jaxonFowler/Clay-Counter/hardware/Clay Counter BOM - Rev4.0.xlsx

Carted? | RefDes | Item | Tolerance | Qty | Purchase Location
TRUE | U1 | ESP32-C3-MINI-1 |  | 1 | Digikey
TRUE | U2 | OLED |  | 1 | Universal Solder
TRUE | U3 | MCP1700T-3302E/TT |  | 1 | Digikey
TRUE | J1 | TP4056 |  | 1 | Amazon
TRUE | J2 | USBC Jack |  | 1 | Unikeyic
TRUE | BT1 | 18650 Battery |  | 1 | Digikey
TRUE | SW1 | Slide Switch |  | 1 | Digikey
TRUE | SW2 & NAV | Button Switch |  | 6 | Digikey
TRUE | R1-R2 | 4.7K Resistor | 5% | 2 | Digikey
TRUE | R3-R7 | 10K Resistor | 5% | 5 | Digikey
TRUE | R8-R9 | 100K Resistor | 1% | 2 | Digikey
TRUE | R10-R11 | 5.1K Resistor | 5% | 2 | Digikey
TRUE | C1 | 10uF Capacitor | 10% | 1 | Unikeyic
TRUE | C2-C3 | 100nF Capacitor | 5% | 2 | Unikeyic
TRUE | C4 | 4.7uF Capacitor | 10% | 1 | Unikeyic
