jaxonFowler/Clay-Counter/hardware/ClayCounterCircuit-V2.0.pdf

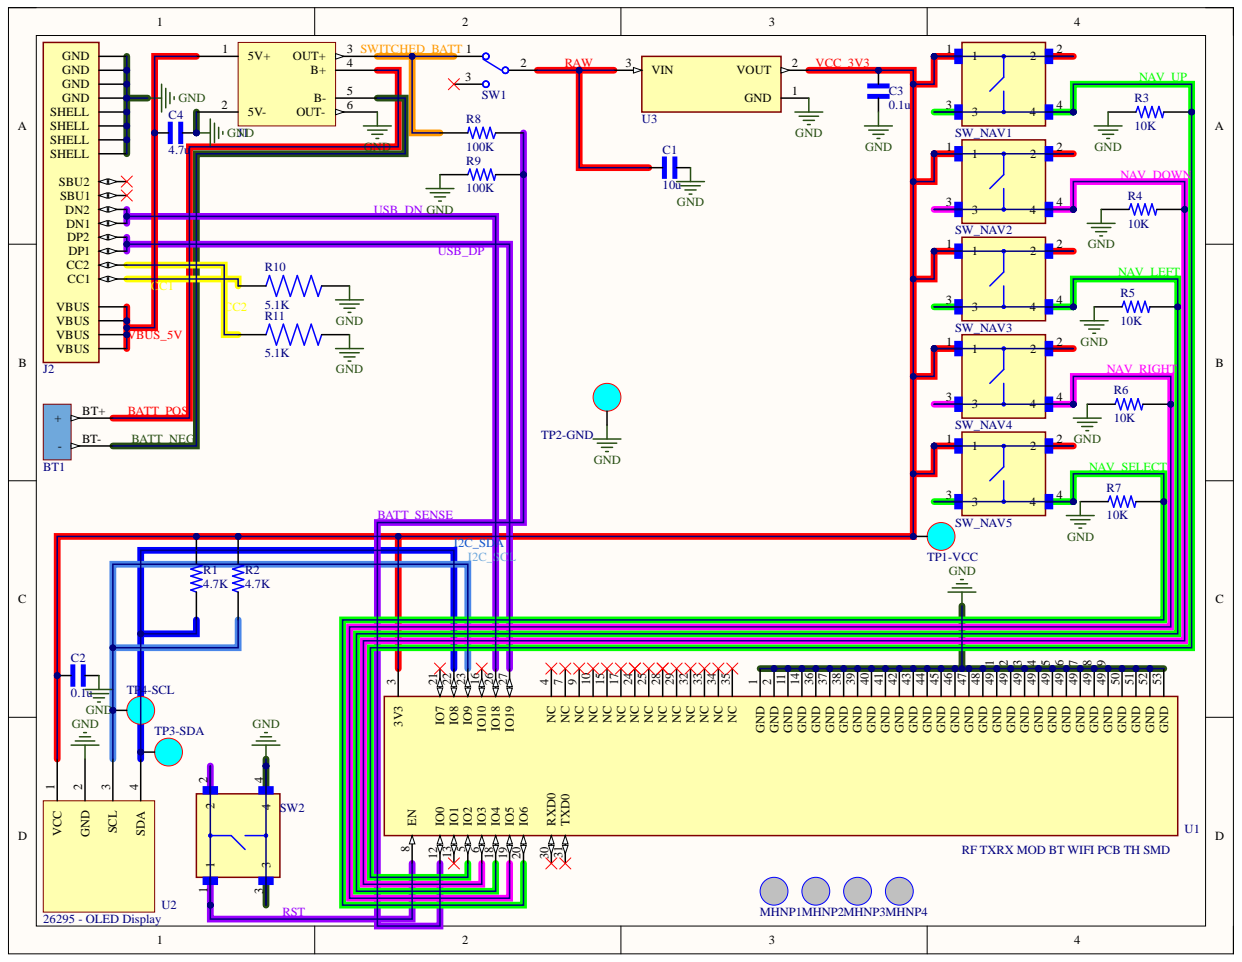
[picture p1: page 1]

VBUS_5V

BATT_POS

I2C_SDA

RF TXRX MOD BT WIFI PCB TH SMD
