jaxonFowler/Clay-Counter/hardware/Clay_Counter-Altium/ClayCounterPCB.pdf

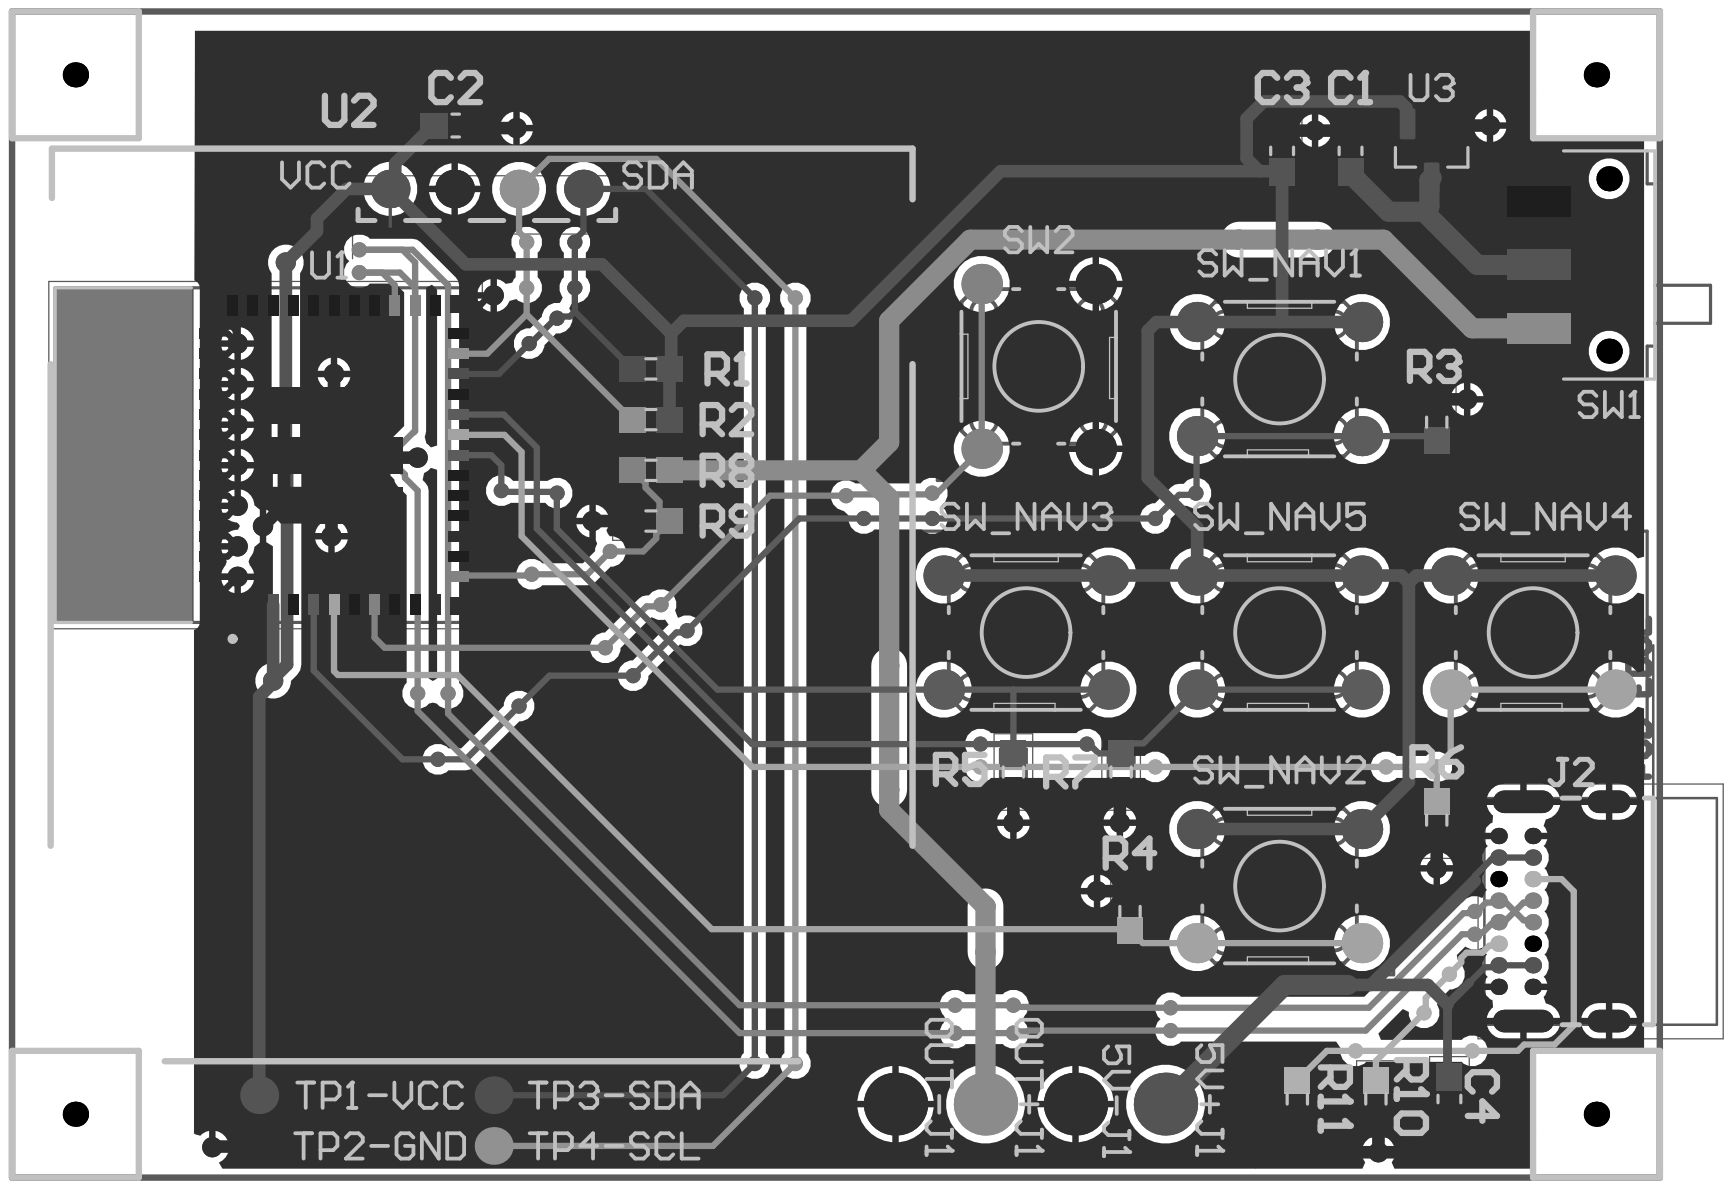
[picture p2: page 1]
