jaxonFowler/Clay-Counter/hardware/ClayCounterCircuit.pdf

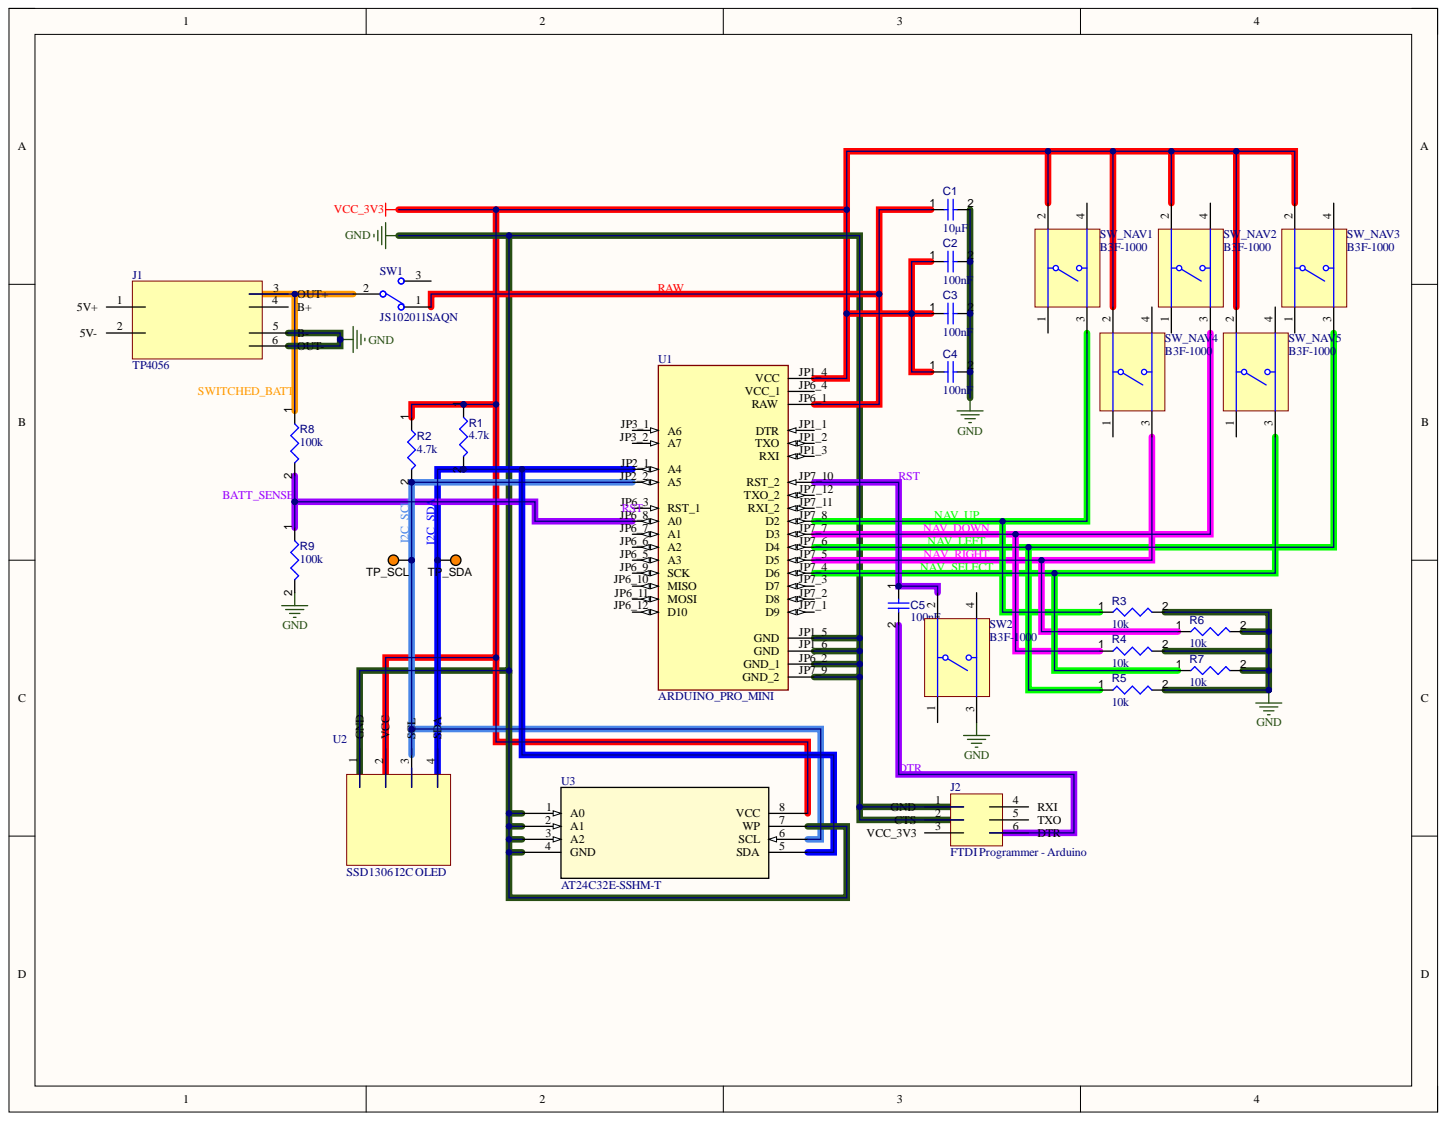
[picture p3: page 1]

J P 2 _ 2 | A 5 RST _ 2 T X O _ 2 RST _ 1 RX I_ 2 A 0 D 2 A 1 D 3 A 2 D 4 A 3 D 5 SC K D 6 MIS O D 7 MO S I D 8 D 1 0 D 9 G N D | JP7 | _ 1 0
J P | 6 _ 3 T | | JP7 | _ 1 2 _ 1 1 _ 8 | N
RS J P
6 _ 8 | | J P7

6 _ 6 | | J P7 | _ 6 | N | AV _LE FT
6 _ 5 | | J P7 | _ 5 | N AV | _RI GH T

G N D | J P 1 | _ 6
G N D _ 1 G N D _ 2

2 | A 1 A 2 | 5 SCL 6 WP 7 VCC 8

4 | G N D S D A
