jaxonFowler/Clay-Counter/(list of files, drawings)

Other design files:
hardware/Clay_Counter-Altium/Clay_Counter-Altium.PrjPcb
hardware/Clay_Counter-Altium/ClayCounter.PcbLib
hardware/Clay_Counter-Altium/ClayCounter.SchLib
hardware/Clay_Counter-Altium/ClayCounterCircuit-V2.0.SchDoc
hardware/Clay_Counter-Altium/ClayCounterCircuit.SchDoc
hardware/Clay_Counter-Altium/ClayCounterPCB.PcbDoc
