jaxonFowler/Clay-Counter/(commit log)

2026-03-26 Schematic Updates
    [ClayCounterCircuit.SchDoc, Clay_Counter-Altium.PrjPcb]
2026-03-26 More Schematic Updates
    [ClayCounterCircuit.SchDoc]
2026-03-27 PCB START
    [ClayCounterCircuit.SchDoc, ClayCounter_PCB-1.PcbDoc]
2026-03-28 Redesigning the Circuit Using a Custom Lib
    [ClayCounter.PcbLib, ClayCounter.SchLib, ClayCounterCircuit-V2.0.SchDoc, ClayCounterCircuit.SchDoc, ClayCounter_PCB-1.PcbDoc]
2026-03-30 New updates
    using ESP32-C3-MINI-1 instead of arduino. And starting new schematic
    [ClayCounter.PcbLib, ClayCounter.SchLib, ClayCounterCircuit-V2.0.SchDoc]
2026-03-30 Finished Schematic (V2.0)
    [ClayCounter.PcbLib, ClayCounter.SchLib, ClayCounterCircuit-V2.0.SchDoc]
2026-03-31 PCB is Laid Out
    [ClayCounter.PcbLib, ClayCounter.SchLib, ClayCounterCircuit-V2.0.SchDoc, ClayCounterPCB.PcbDoc]
2026-03-31 GND Copper Pour
    Wrapping up for the night
    [ClayCounterPCB.PcbDoc]
2026-04-02 PCB updates
    [ClayCounterPCB.PcbDoc]
2026-04-04 PCB Done?
    Still needs review
    [ClayCounterPCB.PcbDoc]
2026-04-04 Some more touches on the PCB
    [ClayCounterPCB.PcbDoc]
2026-04-06 Firmware start
    File structures and starting outlining
    [Clay Counter BOM - Rev4.0.xlsx, Clay Counter BOM.xlsx, ClayCounterPCB.PcbDoc]
2026-04-07 More code
    [Clay_Counter-Altium.PrjPcb]
2026-04-08 Made another dent in firmware
    [Clay Counter BOM - Rev4.0.xlsx]
2026-10-21 Add README, update project notes, stop tracking build output and local settings
    [Clay_Counter-Altium.PrjPcb]
